ProDesLab/NiCE5340_V1.0-SoM/Drawings/NiCE5340 - LGA Pin Map.pdf

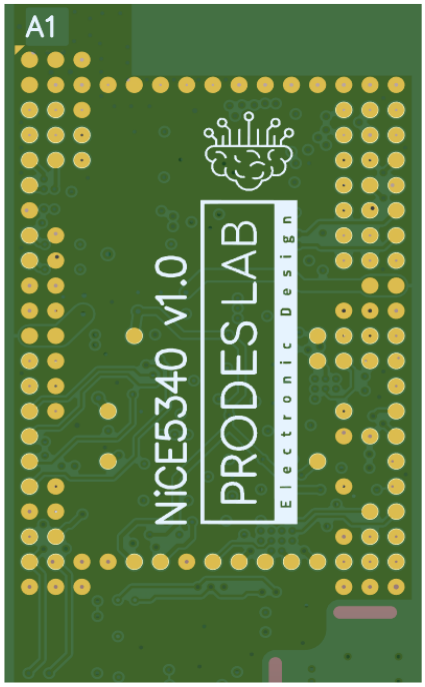
[picture p4: figure]

PAD | 1 | 2 | 3 | 4 | 5 | 6 | 7 | 8 | 9 | 10 | 11 | 12 | 13 | 14 | 15 | Type | Voltage | Owner
A | GND | GND | GND | | | | | | | | | | | | | GPIO | 1V8 | nRF5340
B | GND | GND | GND | GND | GND | GND | GND | GND | GND | GND | GND | GND | GND | GND | GND | Input | 1V8 | Touch
C | P1.13 | P1.11 | GND | | | | | | | | | | nRF RST | P0.26 | P0.25 | USB | 3V3 | nRF5340
D | P0.05 | P1.12 | P1.10 | | | | | | | | | | SWD CLK | SPI CS | P0.28 | I/O | VSYS | nPM1100
E | SAR CS1 | SAR CS0 | P0.04 | | | | | | | | | | SWD IO | SPI MISO | SPI IO3 | I/O | 1V8 | MEMS MIC
F | SAR CS2 | | | | | | | | | | | | P0.12 | SPI CLK | SPI IO2 | OUT | VSYS | LRA Haptic
G | GND | | | | | | | | | | | | P0.11 | SPI MOSI | NFC2 | I/O | 1V8 | BCU
H | DN | GND | | | | | | | | | | | P0.10 | P0.09 | NFC1 | GPIO | 1V8 | FPGA
J | DP | GND | | | | | | | | | | | P0.08 | P0.07 | NTC | GPIO | 3V3 | FPGA
K | GND | GND | | | | | | | | | | | | VLIPO | VLIPO | ANALOG IN | / | nPM1100
L | GND | GND | | | | | | | | | | | GND | GND | GND | ANALOG I/O | / | nRF5340
M | VBUS | VBUS | | | VSYS | | | | | | | RST | IOB13 | IOB3 | IOB0 | QSPI | 1V8 | nRF5340
N | SHP HLD | GND | | | | | | | | | | DONE | IOB10 | IOB9 | IOB2 | SWD | 1V8 | nRF5340
P | SHP ACT | GND | | | | | | | | | | | | | RGB2
R | nPM MODE | GND | | VDD 1V8 | | | | | | | | | IOT46 | | RGB1 | Rail Name | Voltage
T | nPM CHG | | | | | | | | | | | | GND | IOT47 | RGB0 | VBUS | 5V
U | nPM ISET | | | 1V8 | | | | | | | | VCC 3V3 | | | IOT37 | VSYS | VBATT / VBUS
V | nPM ERR | GND | | | | | | | | | | | GND | | IOT36 | VLIPO | VBATT
W | GND | GND | | | | | | | | | | | | SCL | SDA | VCC3V3 | 3V3
Y | P1.15 G_LED | P1.14 R_LED | | | | | | | | | | | GND | PD1 | PD2 | VDD1V8 | 1V8
AA | PDM DATA | PDM CLK | GND | GND | LRA_N | LRA_P | GND | VC SELS | VC SELA | LED3 | LED2 | LED1 | P GND | PD REF | PD3 | 1V8 | 1V8
AB | GND | GND | GND | | | | | | | | | | GND | GND | GND | GND | 0V

# NiCE5340 LGA Pin Map

# Bottom View 21.06.2024
