ProDesLab/NiCE5340_V1.0-SoM/Media/1714388781166.jpg

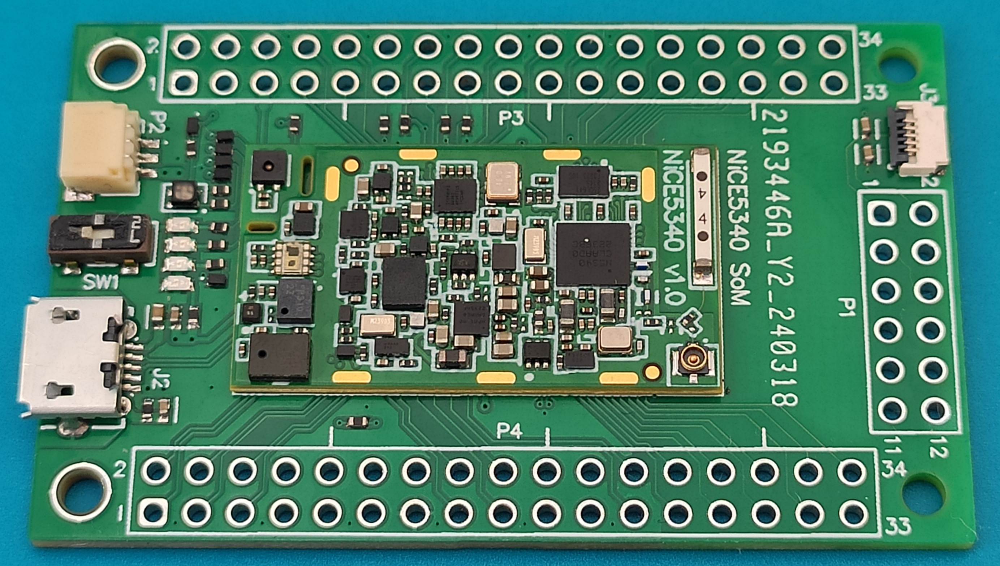
Media/1714388781166.jpg
