ProDesLab/NiCE5340_V1.0-SoM/Schematic/NiCE5340.pdf

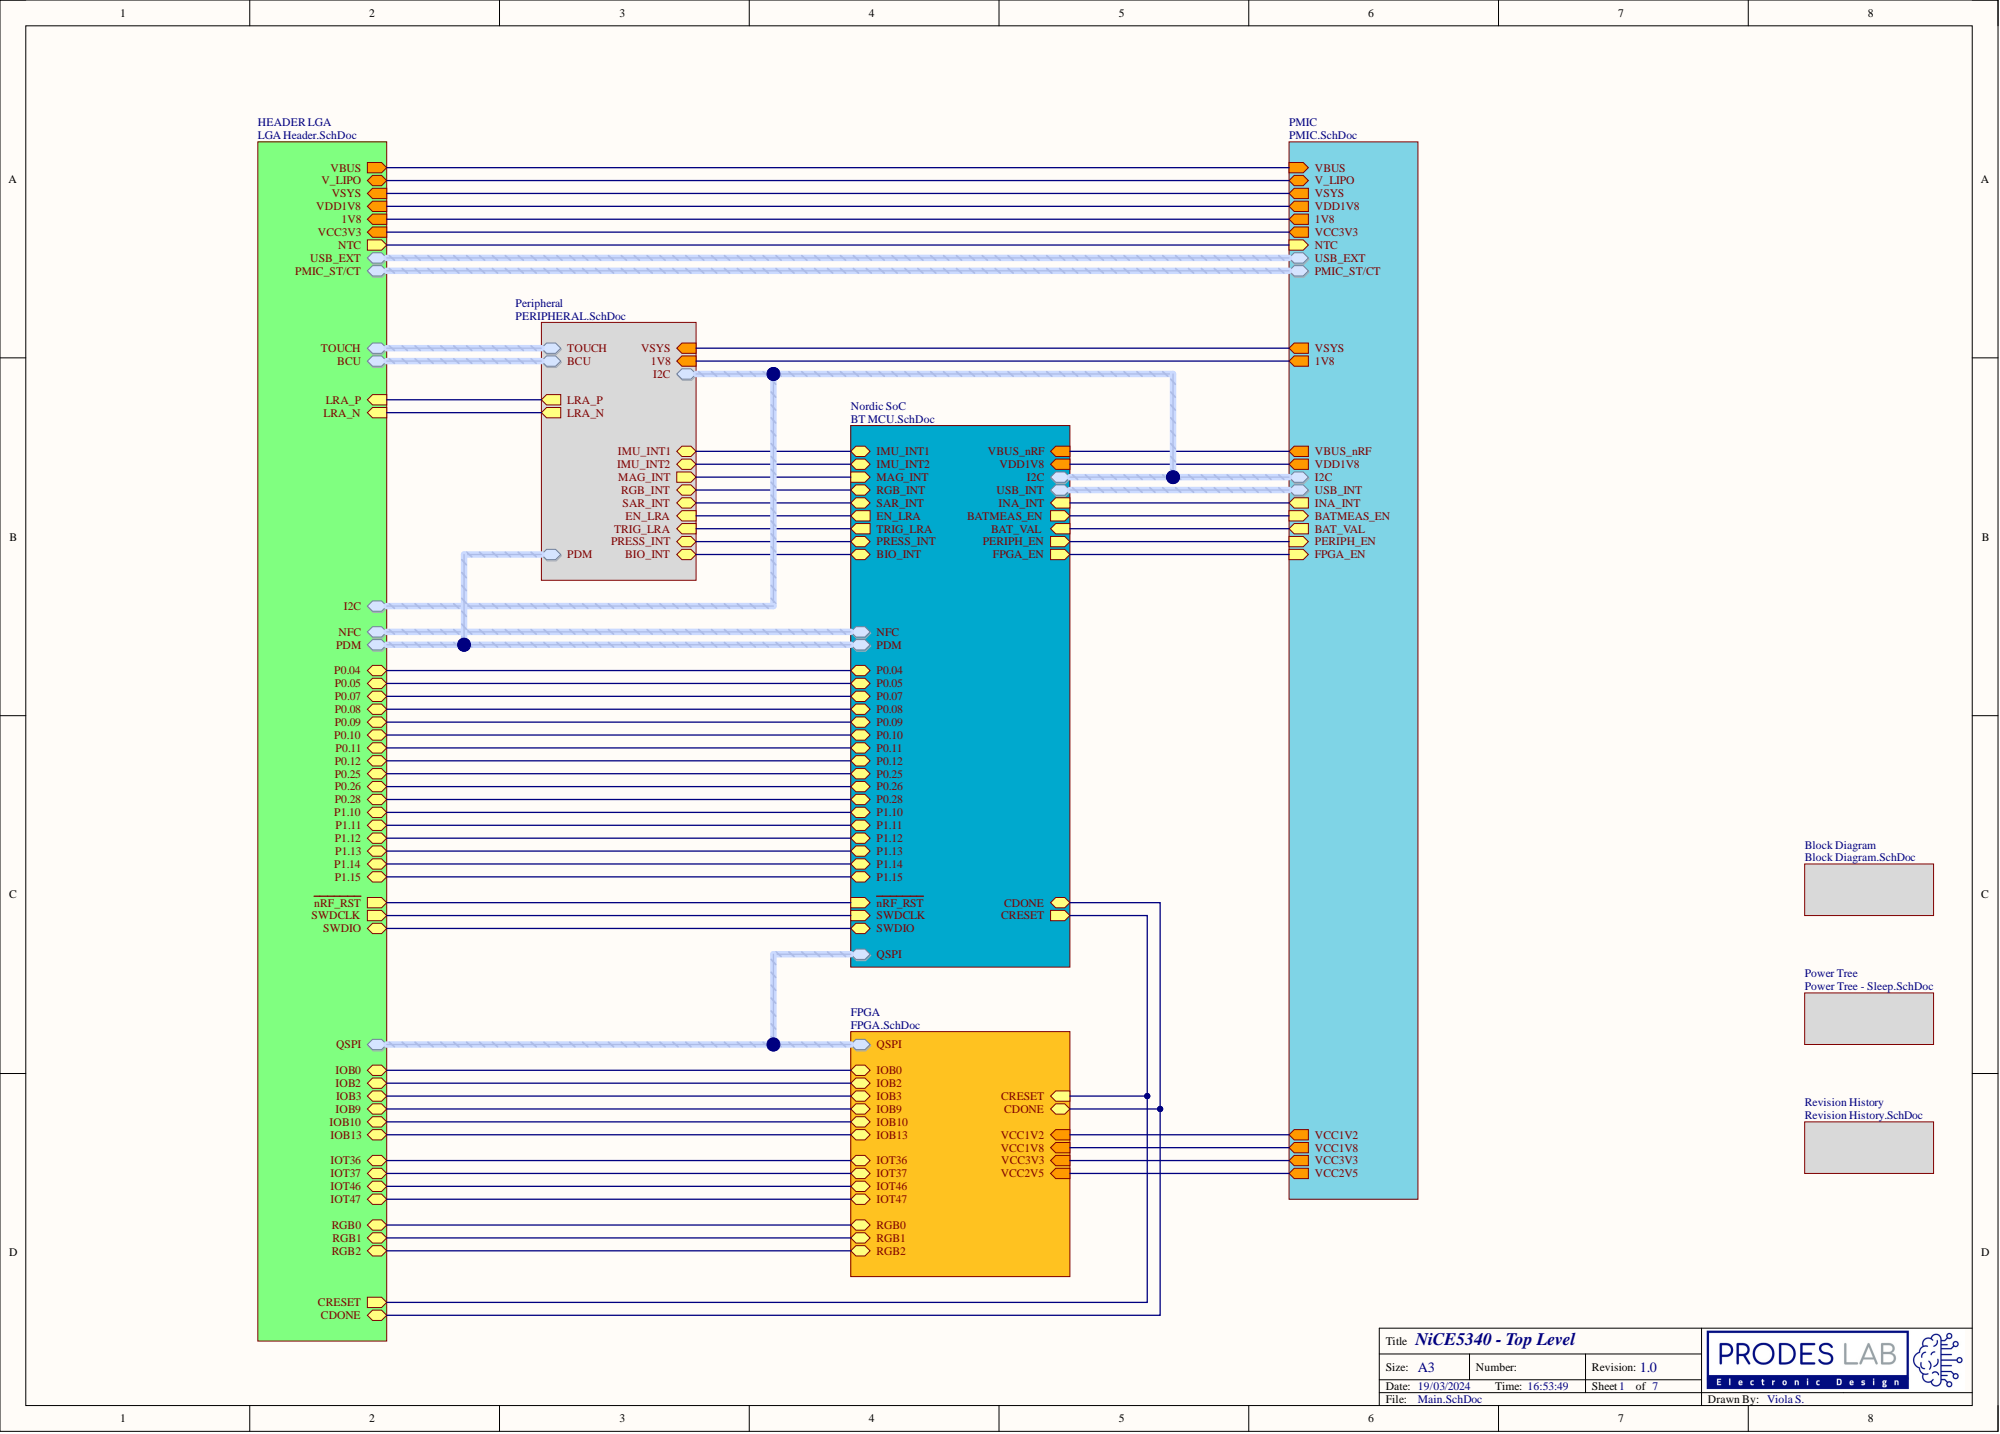
[picture p9: page 1]

Power Tree
Power Tree - Sleep.SchDoc

IOB9 CDONE
IOB10 IOB13 VCC1V2 VCC1V8 IOT36 VCC3V3 IOT37 VCC2V5 IOT46 IOT47 RGB0 RGB1 RGB2

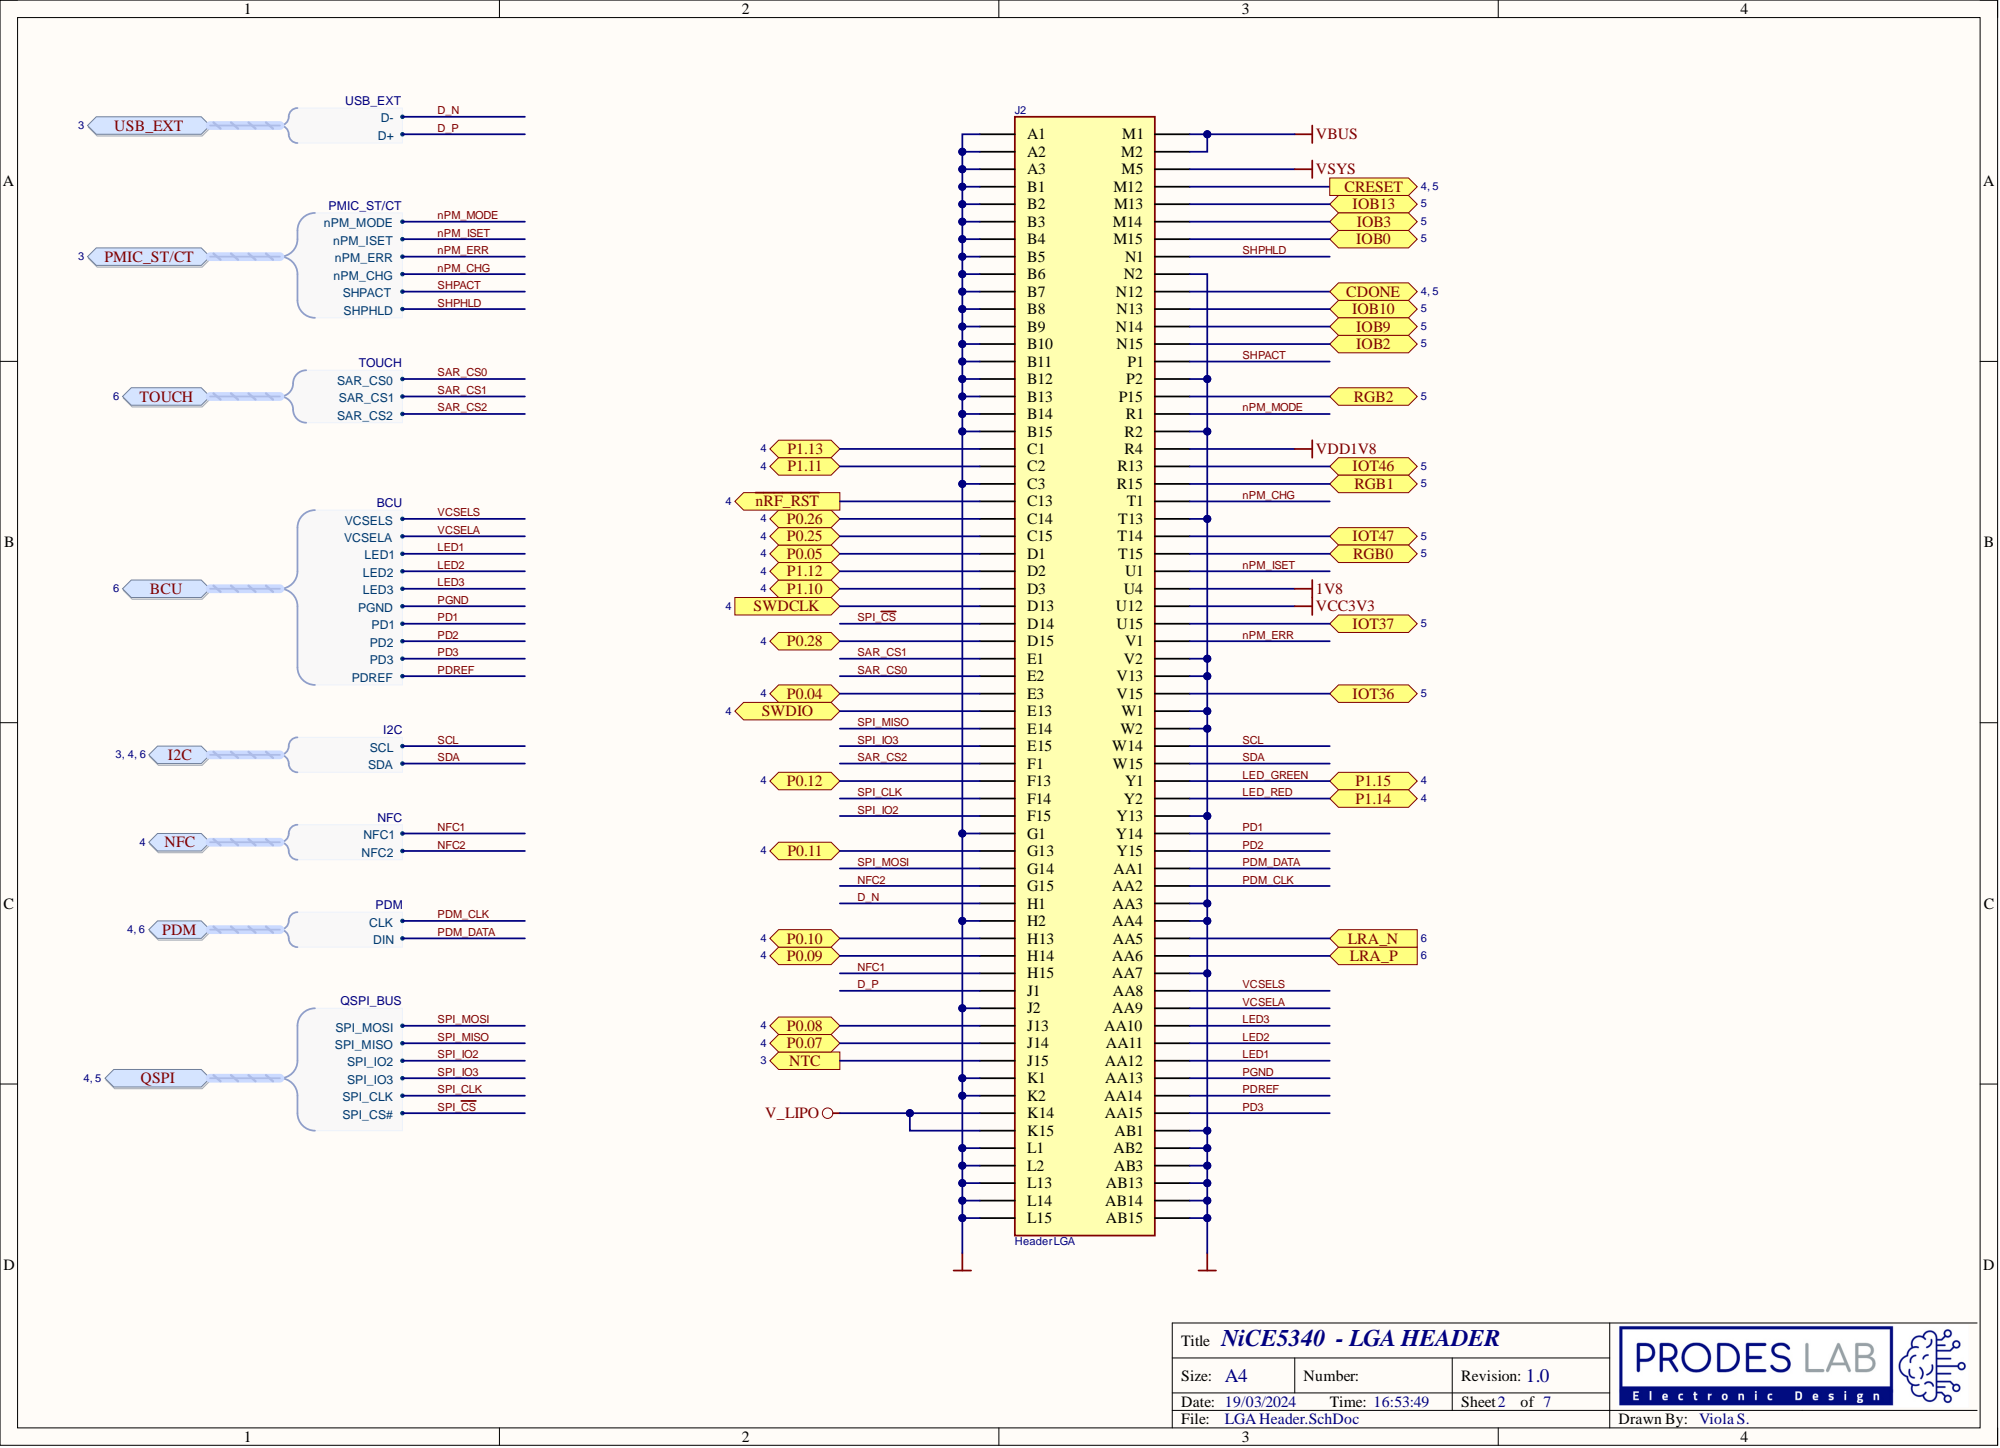
[picture p10: page 2]

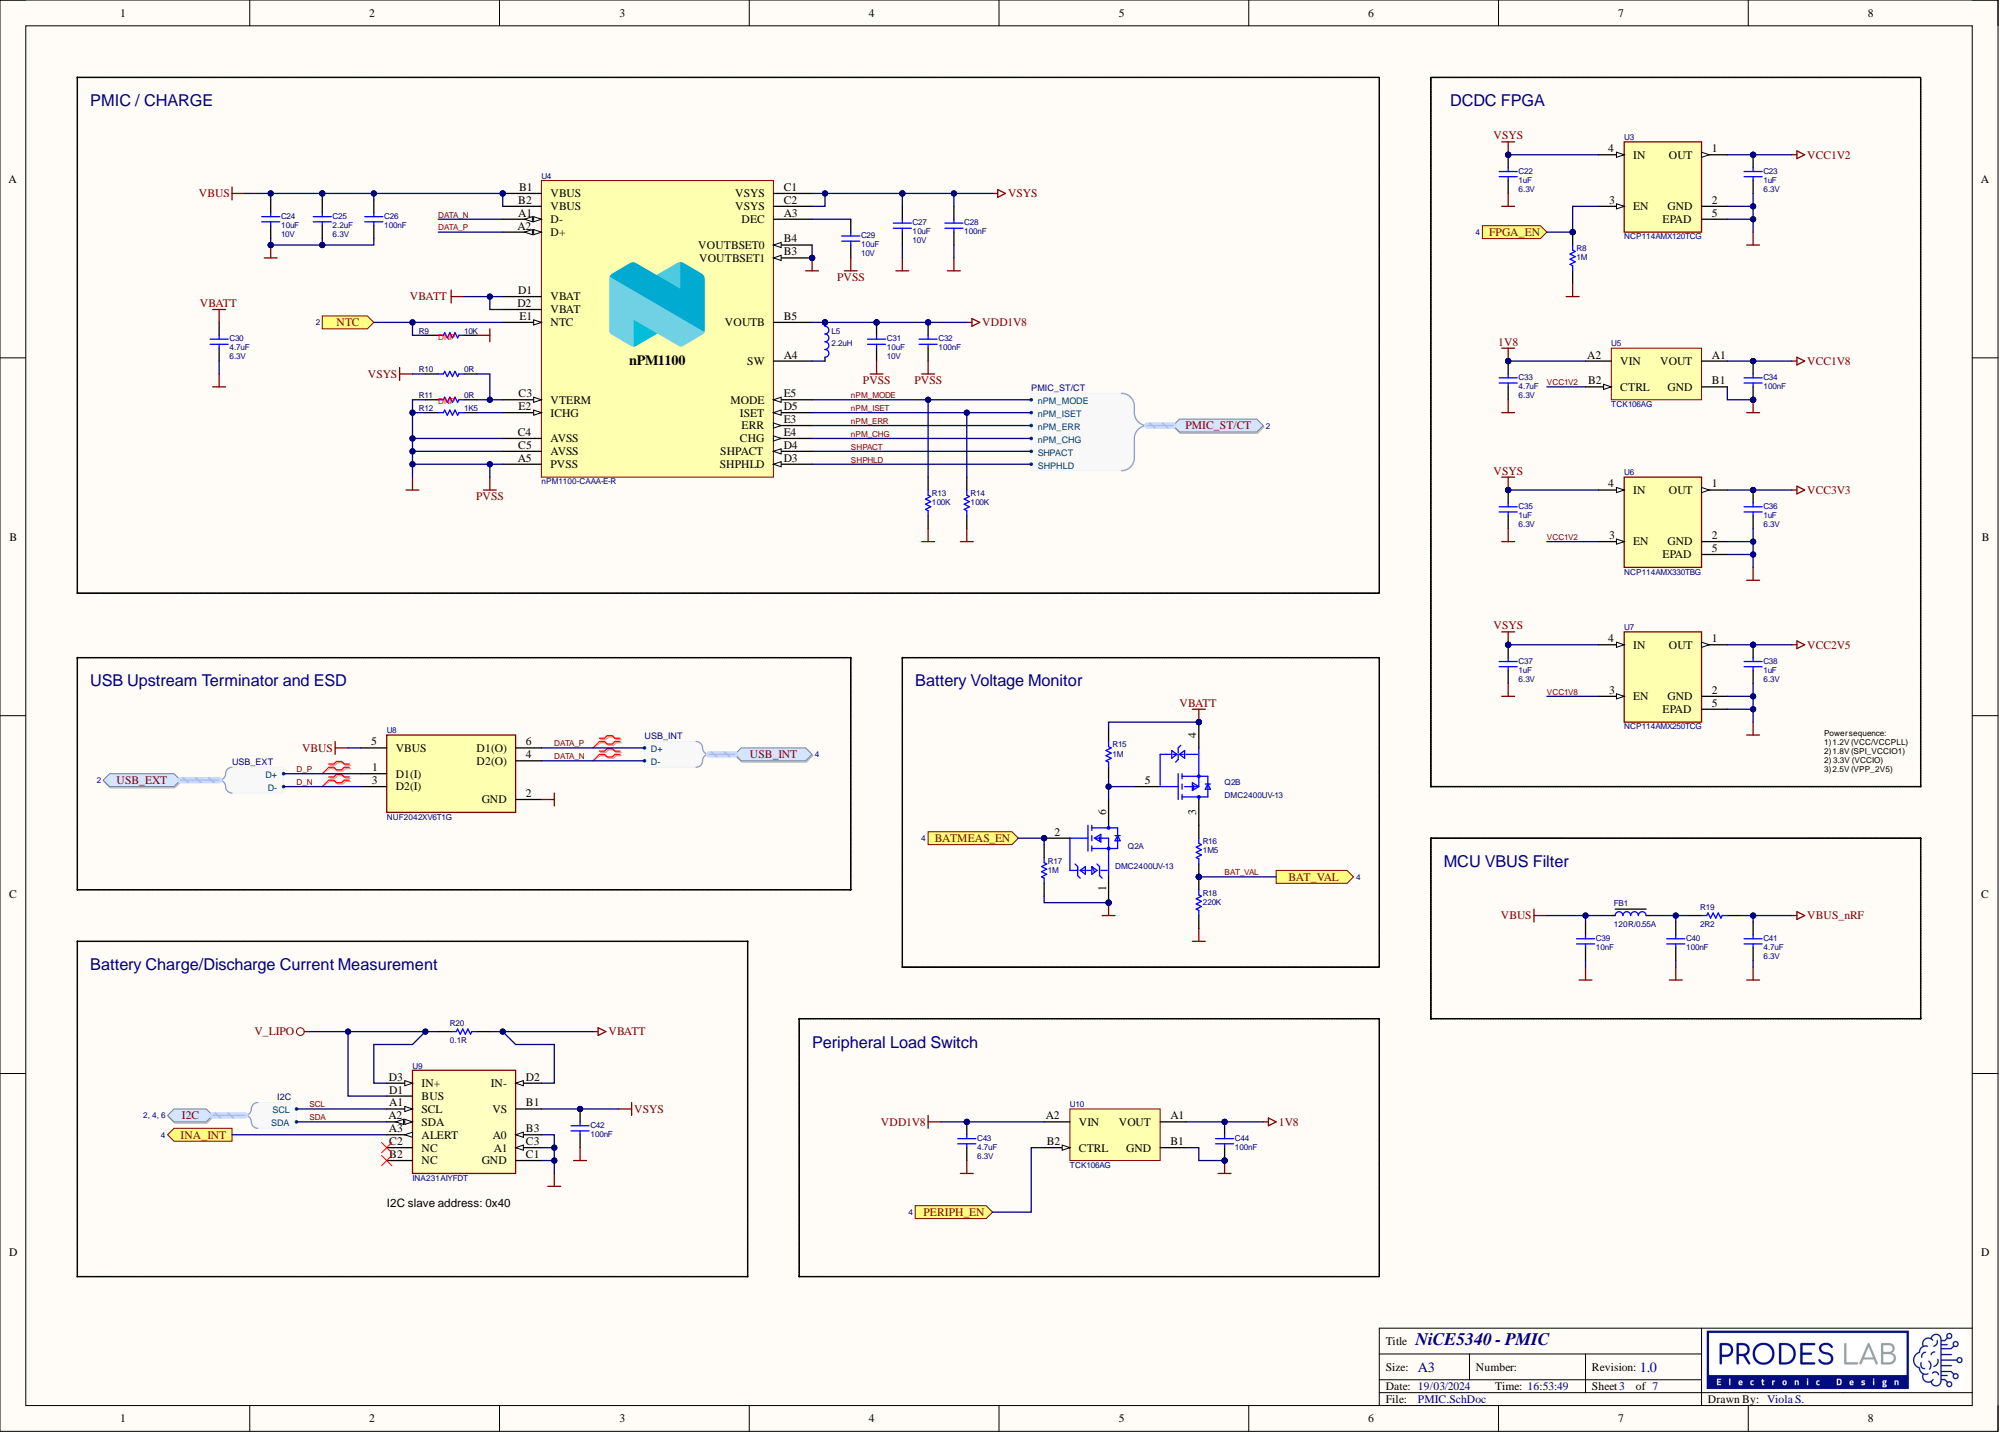
[picture p11: page 3]

USB Upstream Terminator and ESD

Battery Charge/Discharge Current Measurement

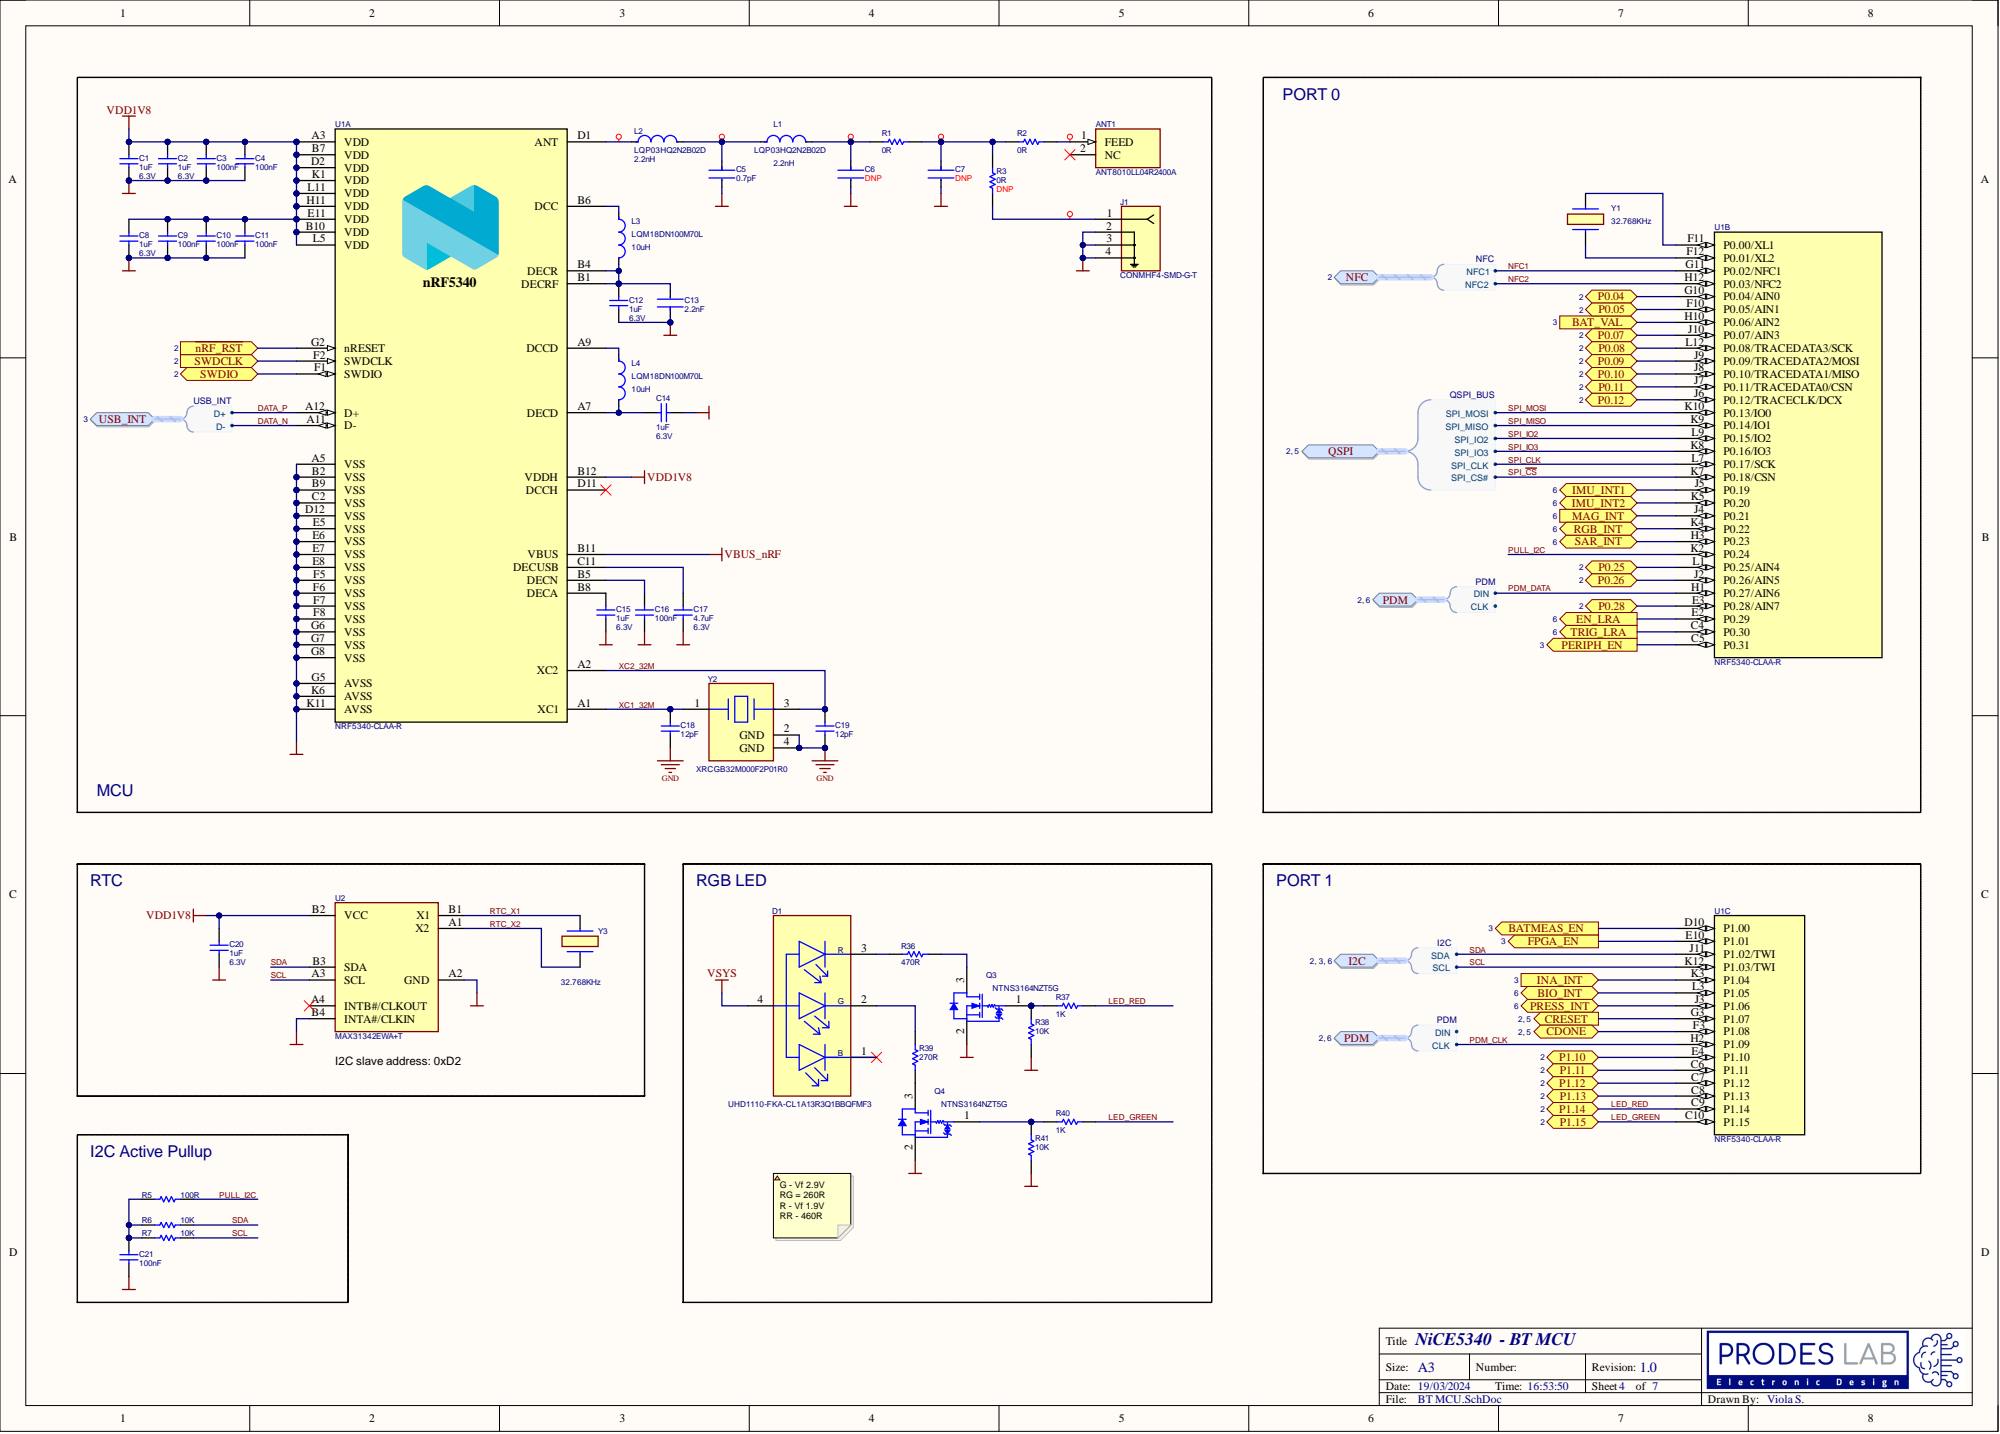
[picture p12: page 4]

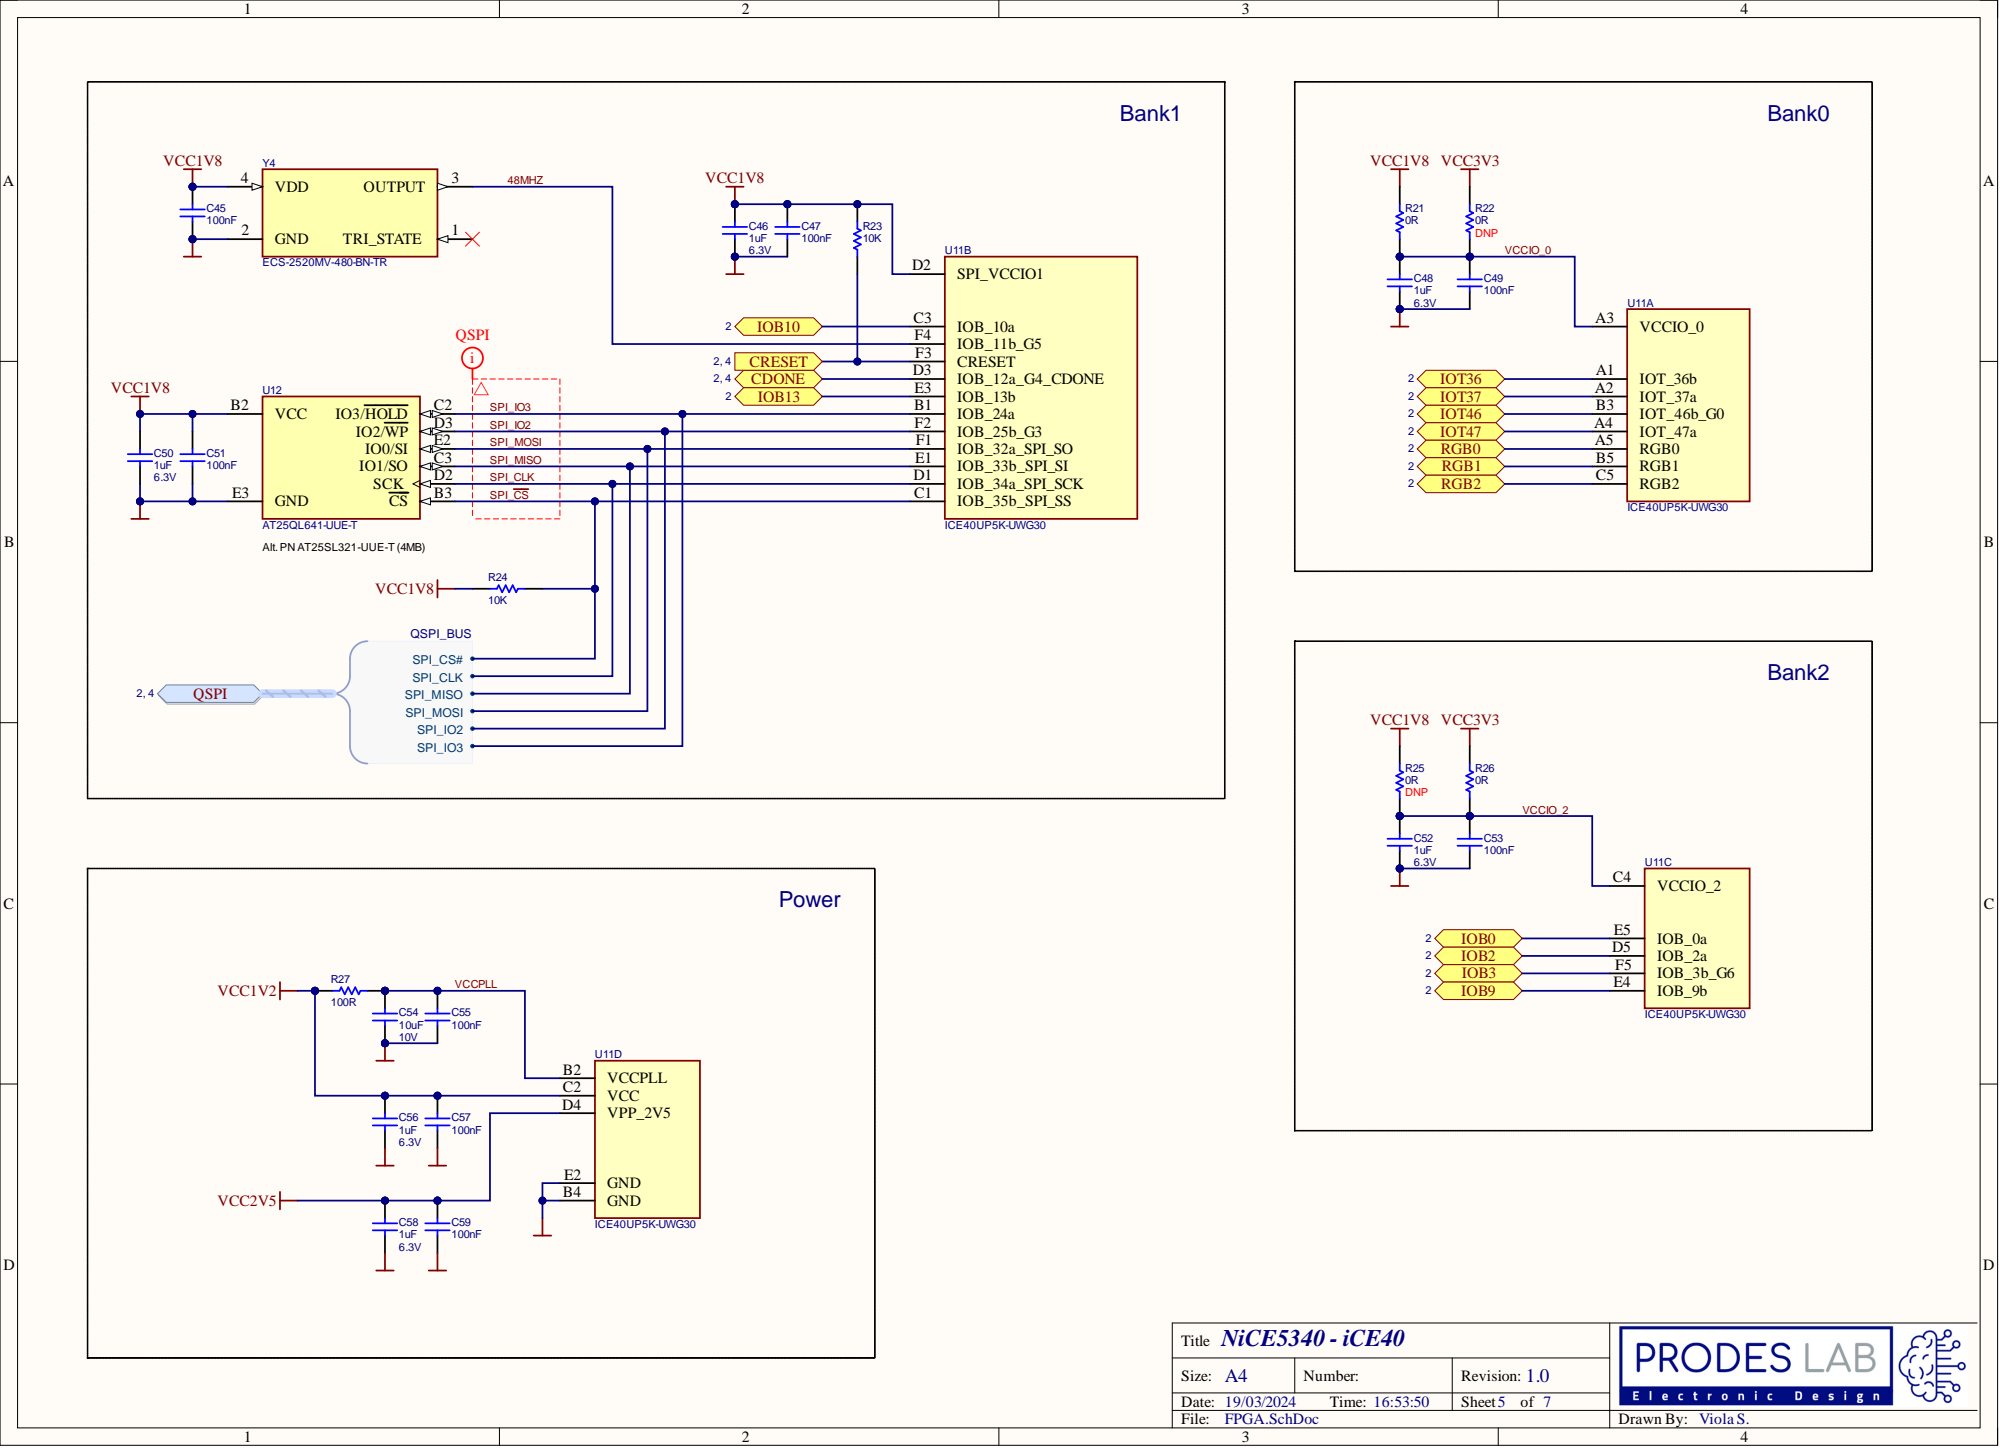
[picture p13: page 5]

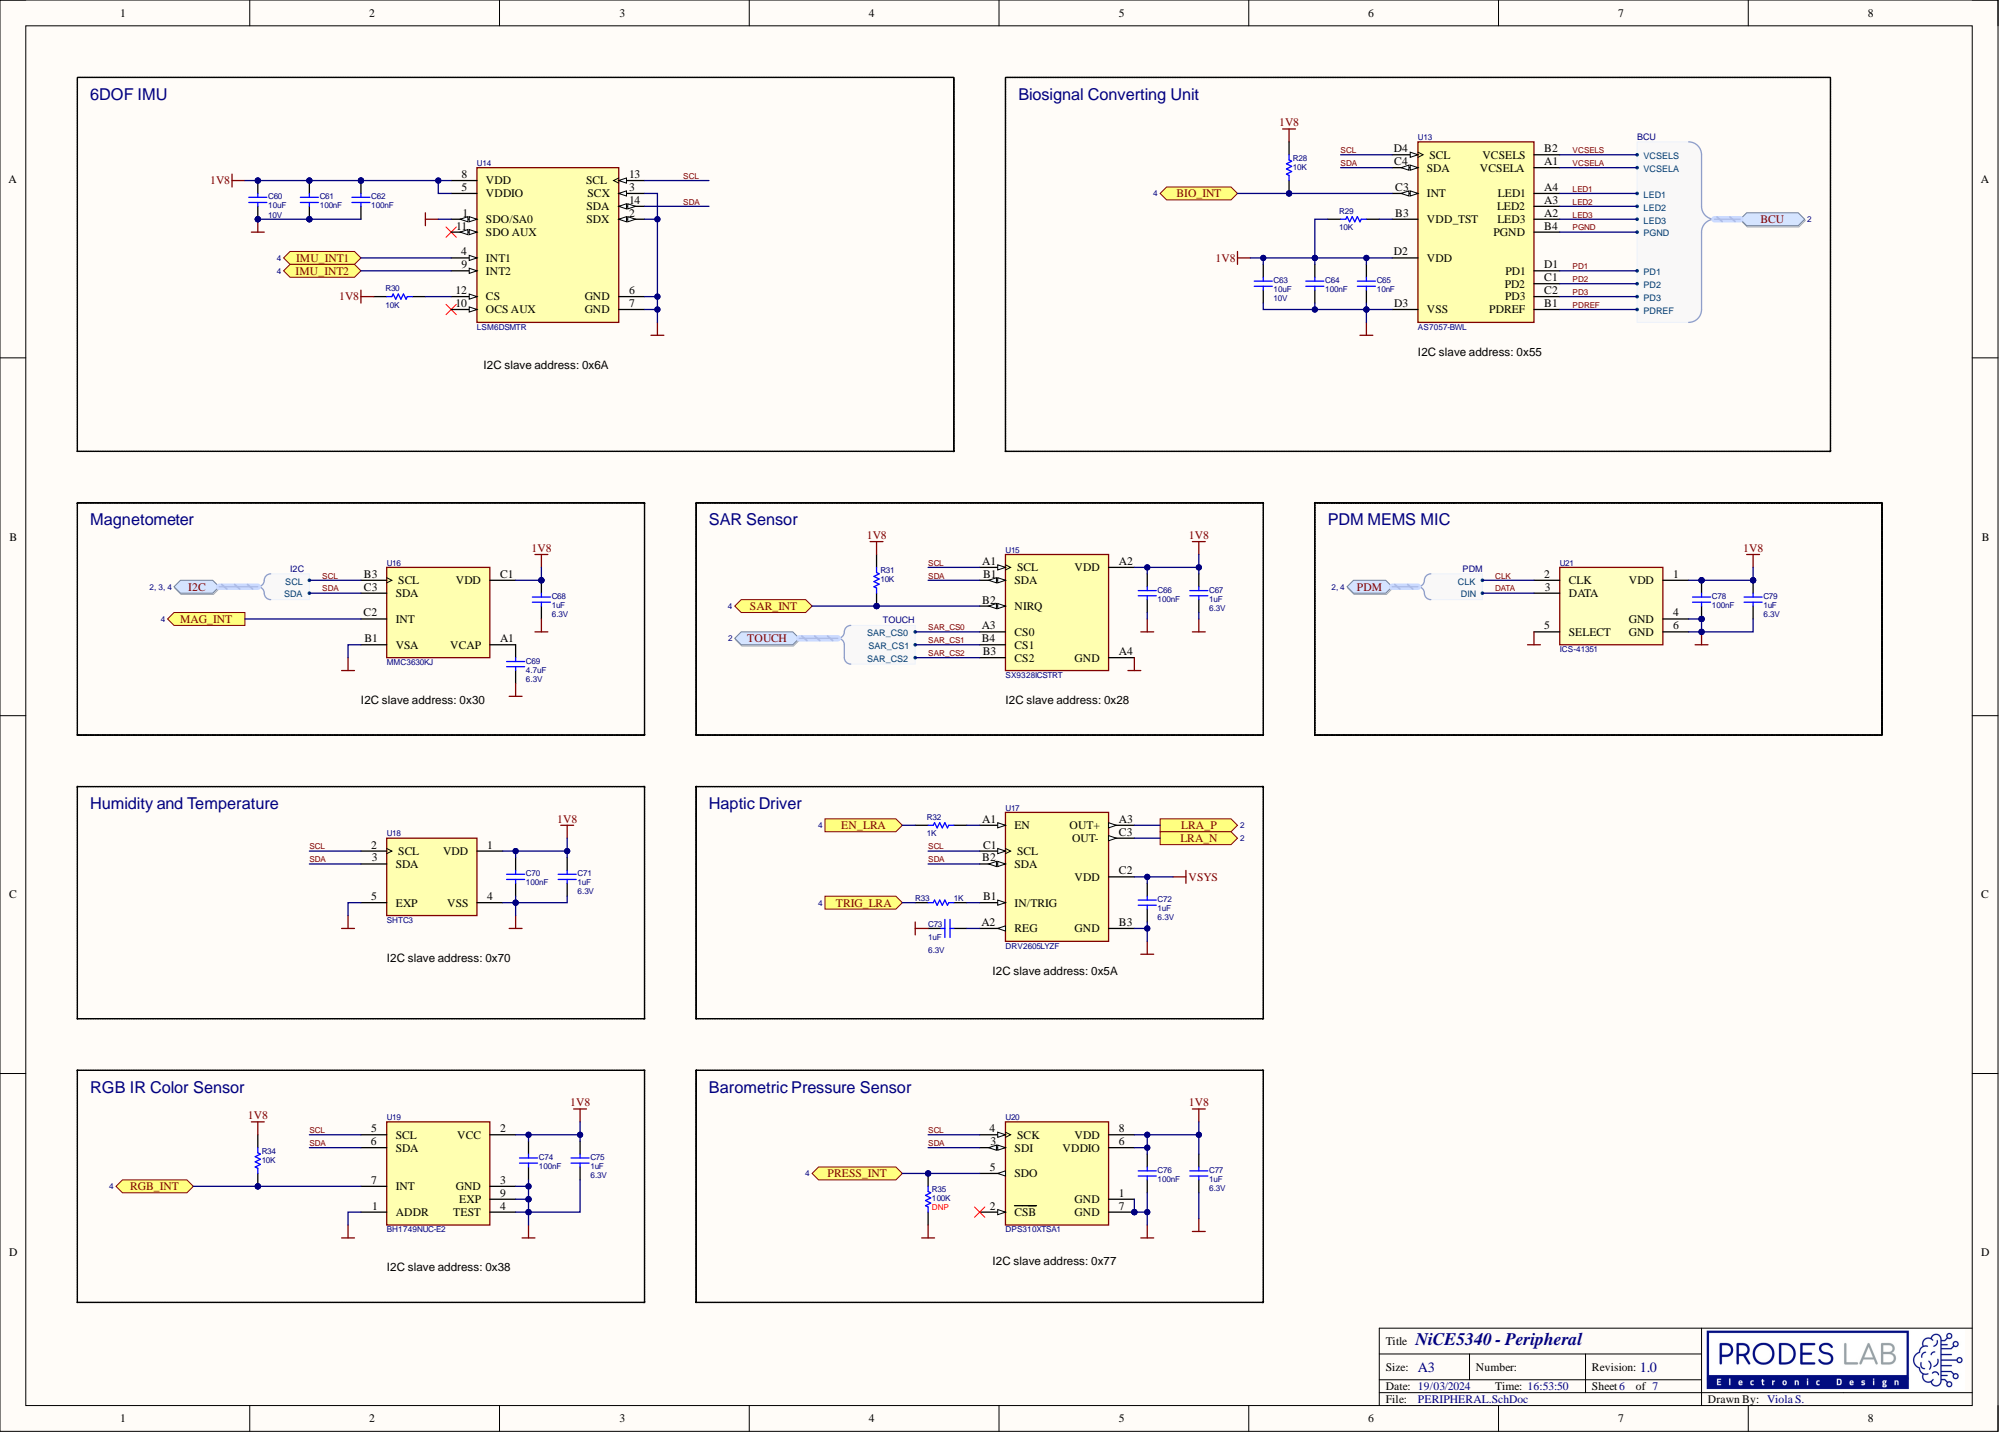
[picture p14: page 6]

RGB IR Color Sensor

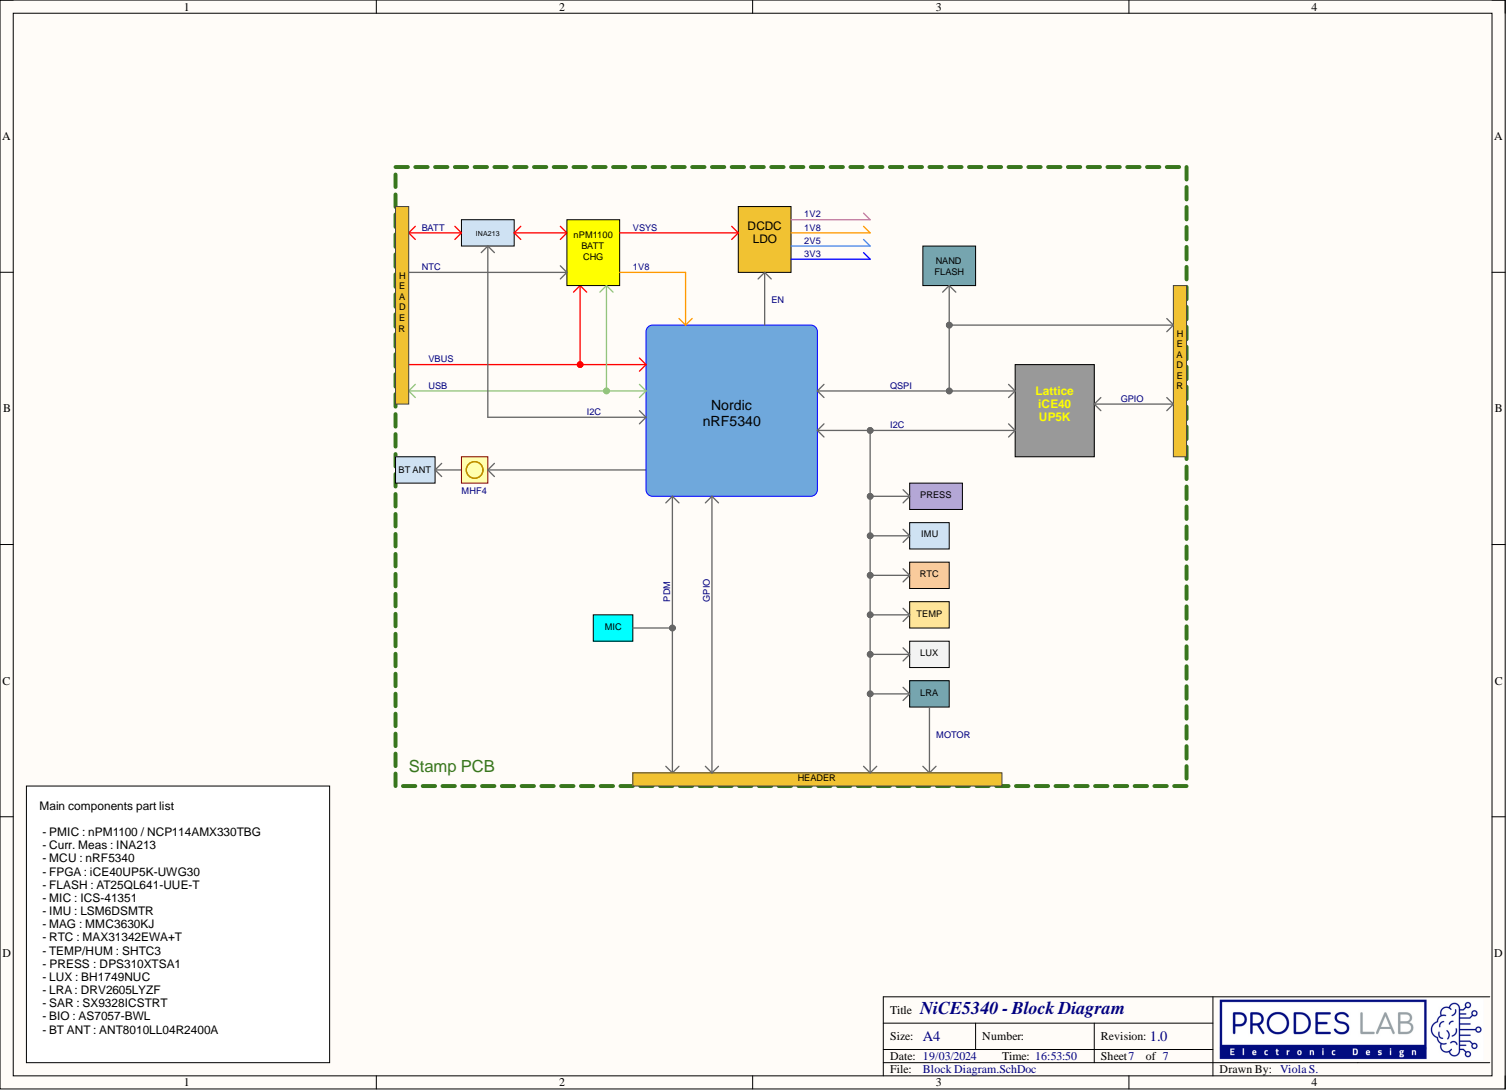
[picture p15: page 7]

Main components part list
