ProDesLab/NiCE5340_V1.0-SoM/Drawings/NiCE5340 - 3D View.pdf

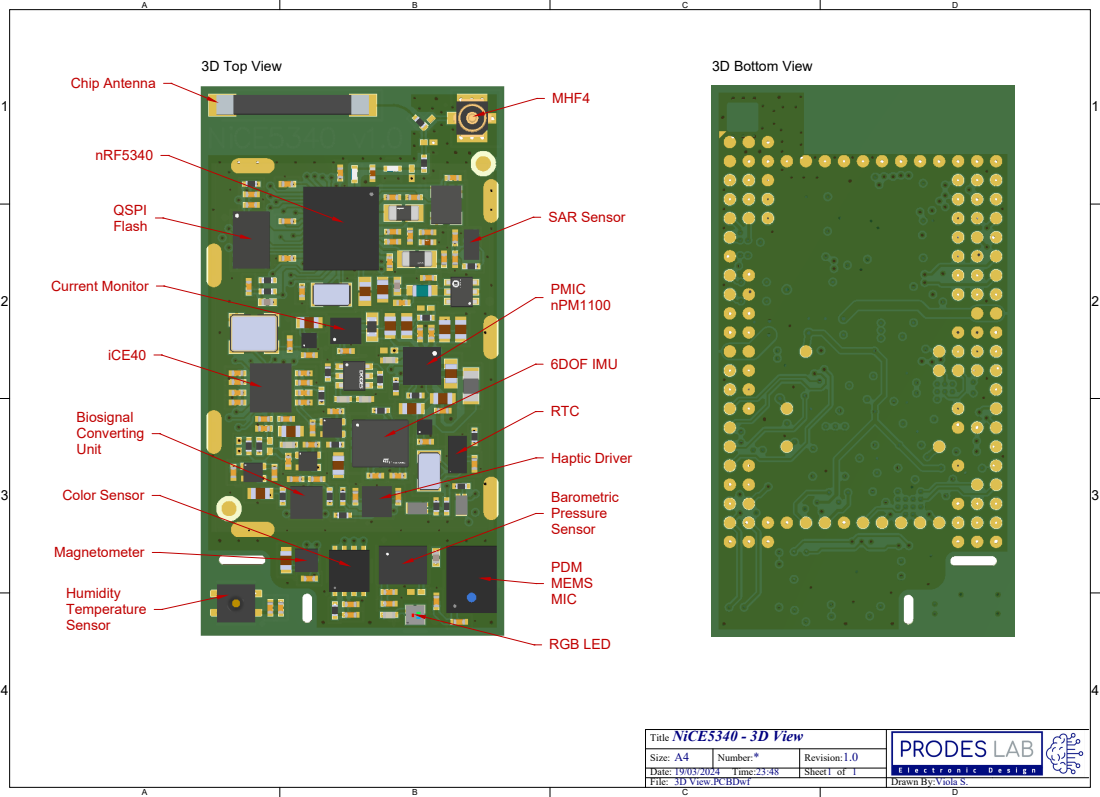
[picture p16: page 1]
NiCE5340 - 3D View; 3D View.PCBDwf; Title; Size:; Number:; Date: File:; Revision:; Time:; Sheet of; 3D Top View; 3D Bottom View; Chip Antenna; QSPI Flash; iCE40; Biosignal Converting Unit; Humidity Temperature Sensor; Magnetometer; SAR Sensor; MHF4; nRF5340; PMIC nPM1100; 6DOF IMU; Haptic Driver; Barometric Pressure Sensor; PDM MEMS MIC; Color Sensor; Current Monitor; RTC; RGB LED

Drawn By:Viola S.
