ProDesLab/NiCE5340_V1.0-SoM/Drawings/NiCE5340 - Assembly.pdf

A

B

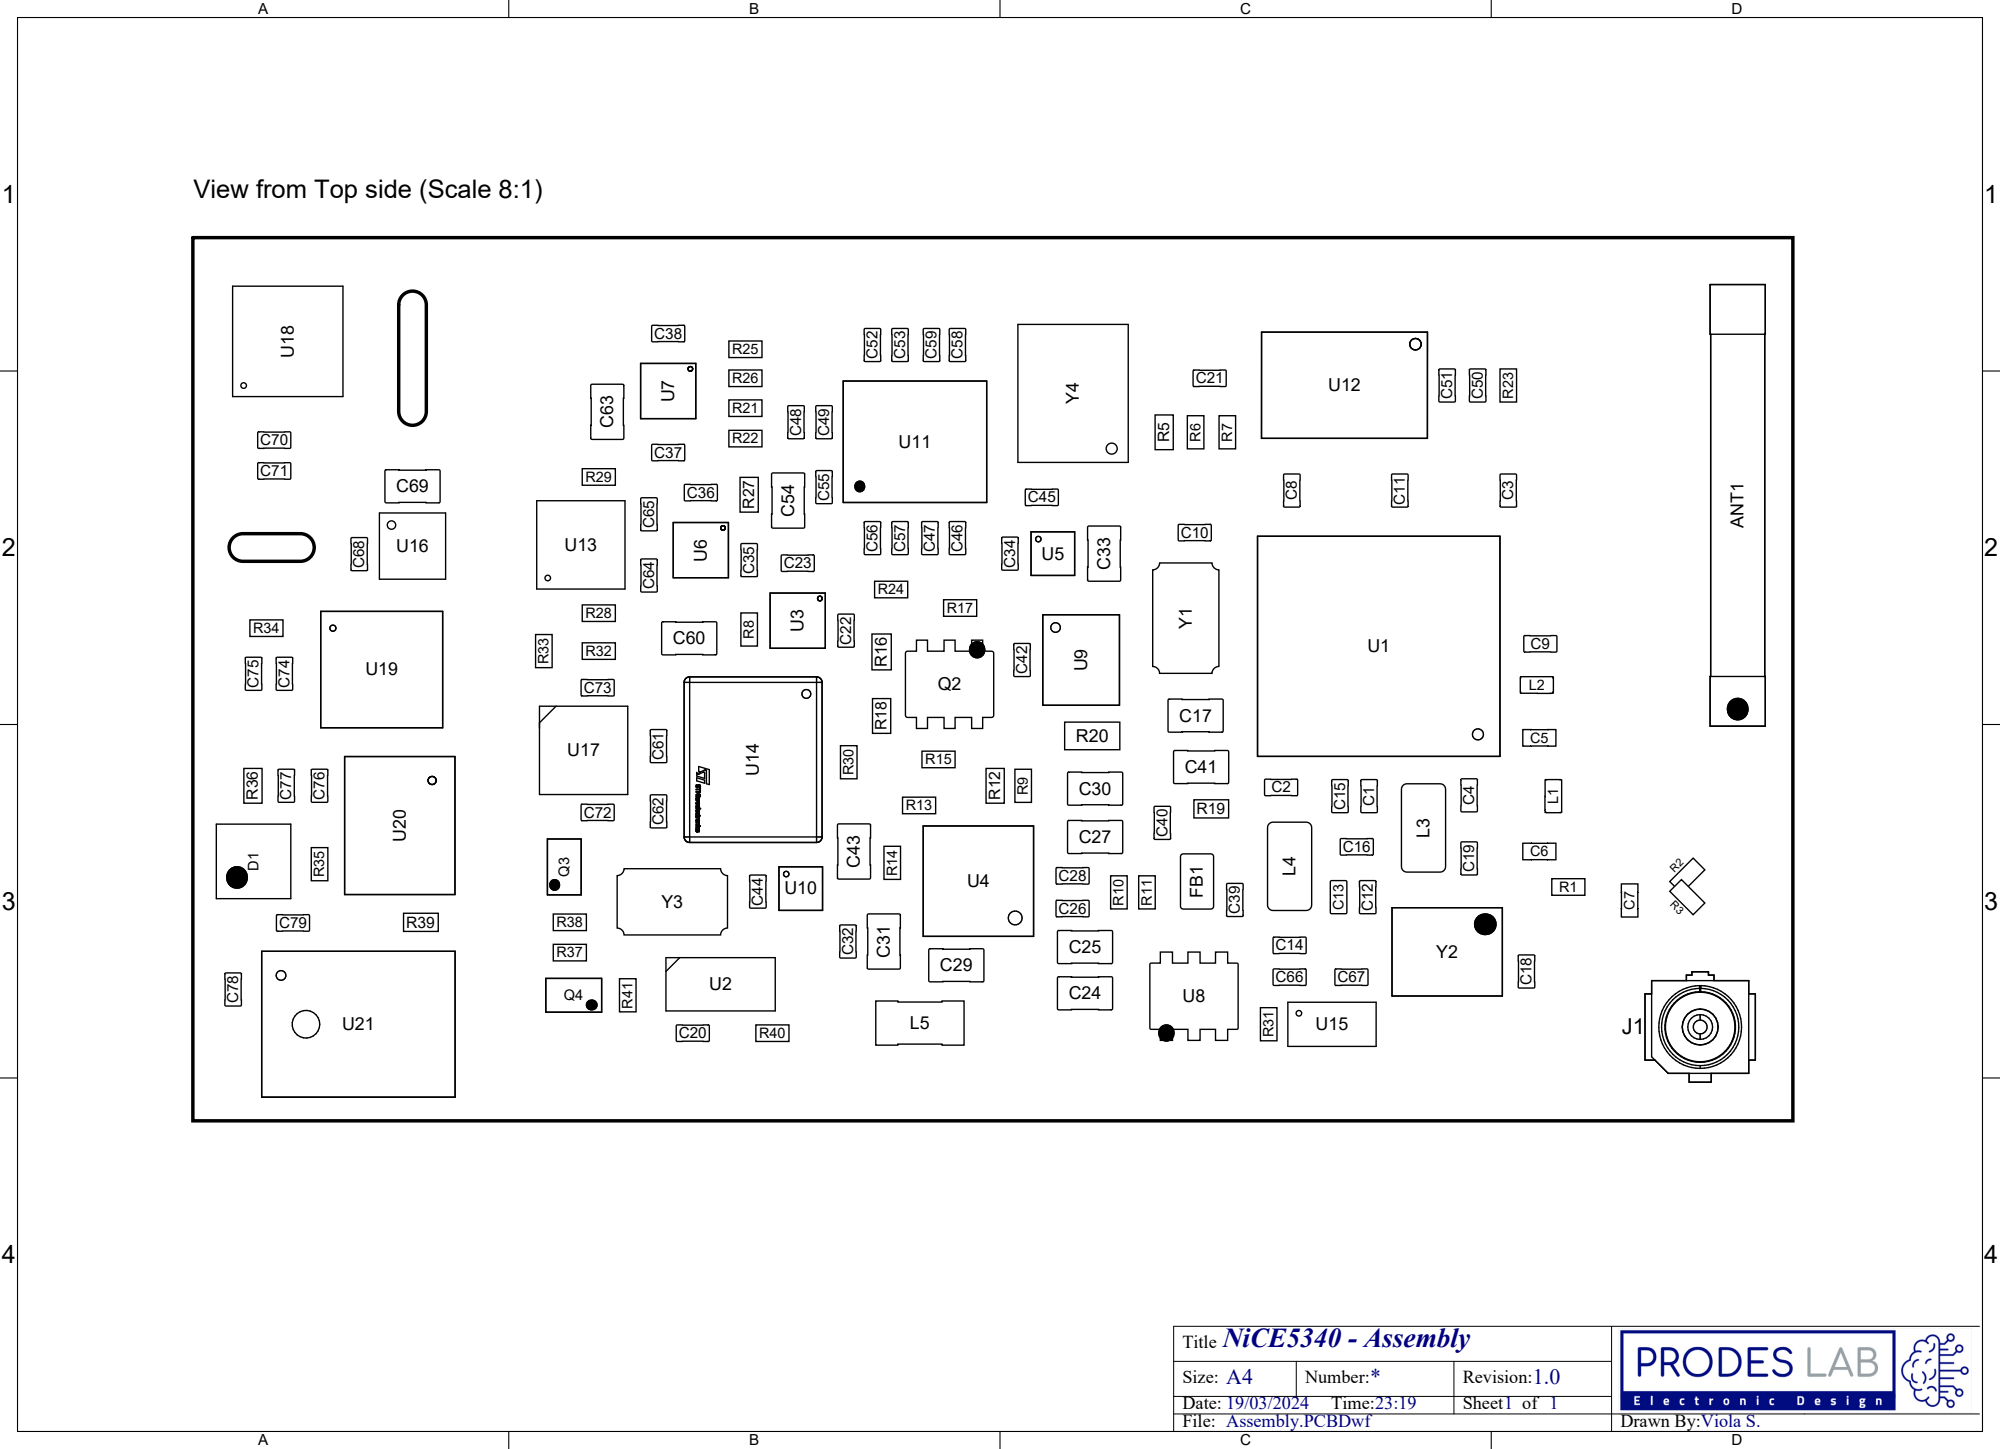
[picture p17: page 1]

View from Top side (Scale 8:1)
