ProDesLab/NiCE5340_V1.0-SoM/Drawings/NiCE5340 - Dimension.pdf

A

B

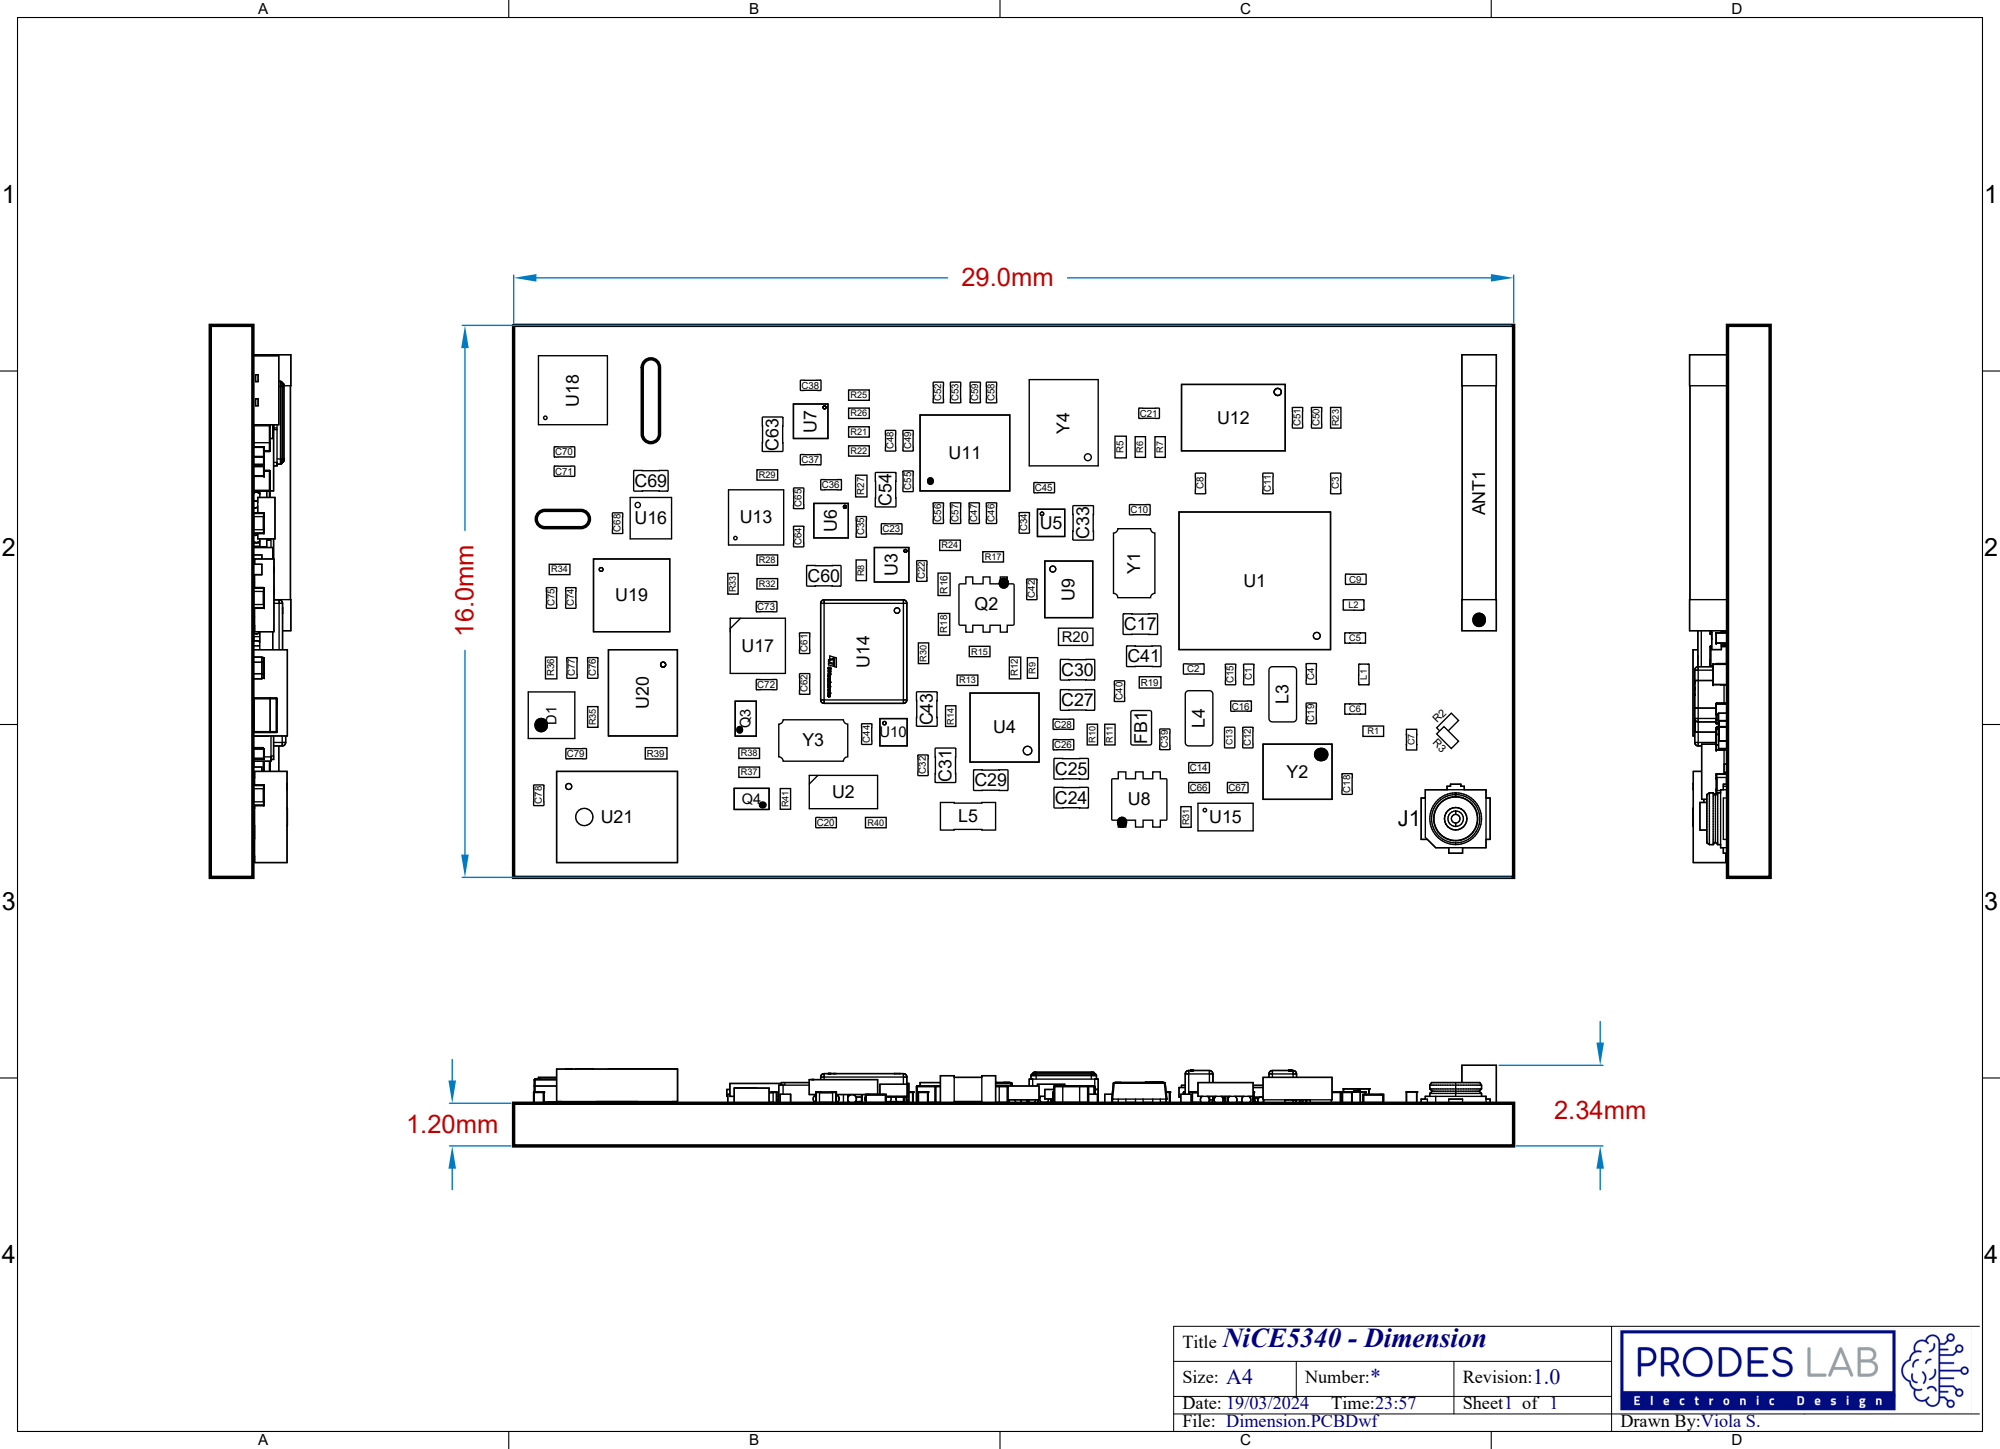
[picture p18: page 1]
