ProDesLab/NiCE5340_V1.0-SoM/(commit log)

2024-05-25 boards: prodeslab: nice5340
    Initial board files for nice5340
2024-05-25 boards: usb: init at boot
    sets usb to initialize at boot
2024-05-25 boards: nice5340: add i2c devices
    adds supported i2c devices to devicetree
2024-05-25 firmware: i2c shell binary
    Adds binary for I2C shell, built for NiCE5340 target
    and using USB console
2024-07-31 boards: hwmv2 update
